Aka-O/Negative-Power-Supply/Final_LabProject.png

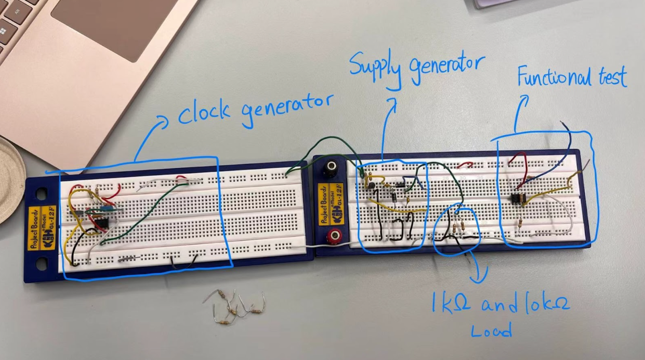
Final_LabProject.png
