Aka-O/Negative-Power-Supply/README.md

# Negative-Power-Supply
This project produces a stable -5V output from a 5V power supply. It makes use of the 555 IC, several Schottky diodes and transistors.

Created for the course ELEC3106 | Electronics
