Aka-O/Negative-Power-Supply/Simulation_LabProject.png

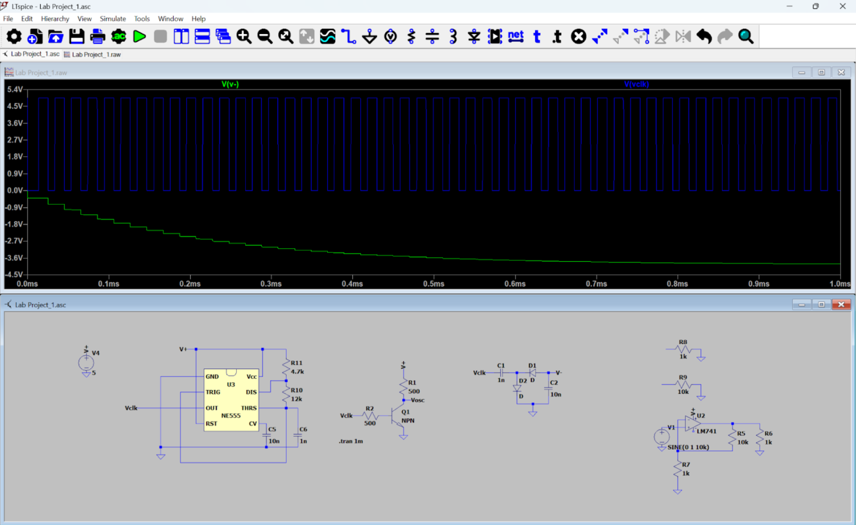
Simulation_LabProject.png
