Aka-O/Negative-Power-Supply/Lab Project_1.asc

C1: cap; 1n
C2: cap; 10n
C5: cap; 10n
C6: cap; 1n
D1: diode
D2: diode
Q1: npn
R1: res; 500
R2: res; 500
R5: res; 10k
R6: res; 1k
R7: res; 1k
R8: res; 1k
R9: res; 10k
R10: res; 12k
R11: res; 4.7k
U2: LM741
U3: NE555
V1: voltage; SINE(0 1 10k)
V4: voltage; 5
Named nets: V+, Vclk, 0, Vosc, V-
.tran 1m
