Aka-O/Negative-Power-Supply/Lab_project.asc

C1: cap; 200n
C7: cap; 1µ
C8: cap; 1µ
C9: cap; 1µ
C10: cap; 1µ
C11: cap; 1µ
D1: zener
D2: LED
D3: diode; 1N4007
D4: diode; 1N4007
D7: diode; 1N4007
D8: diode; 1N4007
Q1: npn
R1: res; 500
R2: res; 1k
R3: res; 2.35k
R4: res; 3.3k
R5: res; 3.7k
R6: res; 660
R7: res; 1k
R8: res; 1Mega
R9: res; 1k
R10: res; 1k
R11: res; 500
R12: res; 1.7k
R13: res; 300
R14: res; 1k
R15: res; 1k
U1: OP07
U2: LM741
U3: OP07
V5: voltage; PULSE(0 5 15.6u 0.1n 0.1n 25u 50u)
V6: voltage; 5
Named nets: 0, V-, Vcc
.tran 1m
