Aka-O/Negative-Power-Supply/Lab_Project_Final.asc

C1: cap; 10n
C2: cap; 1n
C7: cap; 1µ
C8: cap; 1µ
C9: cap; 1µ
C10: cap; 1µ
D1: schottky
D2: schottky
D3: schottky
D4: schottky
Q1: npn
R1: res; 10k
R2: res; 12k
R3: res; 1k
R4: res; 1k
R5: res; 4.7k
R6: res; 500
R7: res; 1k
R8: res; 500
R9: res; 500
U1: LM741
U2: NE555
V3: voltage; 5
V4: voltage; SINE(0 1 10k)
V5: voltage; PULSE(0 5 0 0.1n 0.1n 0.01m 0.02m)
Named nets: 0, Vcc, V-, Vclk, Vosc
.tran 1m
