Aka-O/Negative-Power-Supply/(commit log)

2026-06-19 Add files via upload
    This report covers our design choices + explanations on how we achieved the project's goal. It will include some explanations of implemented features, screenshots for our measured values (produced voltage), and final results when the produced -5V was used as a negative rail supply for an opamp with various loads.
    Made for the course ELEC3106 | Electronics
2026-06-19 Add files via upload
    Photos of final circuit and simulation results (when -5V is used as the negative power supply for a opamp).
